Shaunmac68/PAT-ECG/Heart Beat Perception Study 2023 v2.1 Commented/Labels for box.docx

Encoder

Speakers

R-Wave Signal

Vibration Signal
