Shaunmac68/PAT-ECG/Heart Beat Perception Study 2023 v2.1 Commented/PAT Task Script.pptx

## PAT TASK SCRIPT – COMPUTER SCREEN

## Welcome to the task – please read the following instructions carefully

PRESS SPACEBAR TO CONTINUE

## This part of the study will test how well you can match your heartbeat with auditory tones

Once you press the spacebar, you will hear a series of tones, those tones represent your own heartbeats

PRESS SPACEBAR TO CONTINUE

## Slide 4

EXAMPLE HEARTBEAT

EXAMPLE
TONE

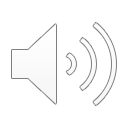
[picture p1: figure]

NOTICE HOW THE TONE IS OUT OF SYNC WITH YOUR HEARBEATS?

PRESS SPACEBAR TO CONTINUE

## Slide 5

It may seem as if there is a delay between the tones you can hear and your own heartbeats you feel

In order to rectify the delay, you will be asked to rotate the dial until the sounds are in sync

PRESS SPACEBAR TO CONTINUE

## Slide 6

TURN LEFT

TURN RIGHT

Turn the dial so that the tone is simultaneous with your perception of the heartbeat

PRESS SPACEBAR TO CONTINUE

## Slide 7

TURN LEFT

Once you are happy with your choice, PRESS SPACEBAR TO CONTINUE

TURN RIGHT

## Slide 8

After each trial you will rate how confident you were about matching your heartbeat to the tone

On a scale of 1 (not confident at all) to 10 (extremely confident) how confident are you that you matched the tone to your heartbeat?
1……………………………………………………………………………………………………………………………………………………….10

Once you are happy with your choice, PRESS SPACEBAR TO CONTINUE

## Slide 9

FOR THE DURATION OF THIS TASK, PLEASE SIT AS STILL AS POSSIBLE AND REFRAIN FROM TENSING YOUR MUSCLES OR ALTERING YOUR BREATHING

PRESS SPACEBAR TO CONTINUE

## Slide 10

REMEMBER
Move the dial so the tone matches your heartbeat to the best of your perception

PRESS SPACEBAR TO CONTINUE

## PHASE ADJUSMENT TASK BEGINS TASK BEGINS
