Shaunmac68/PAT-ECG/CircuitDiagram.jpg

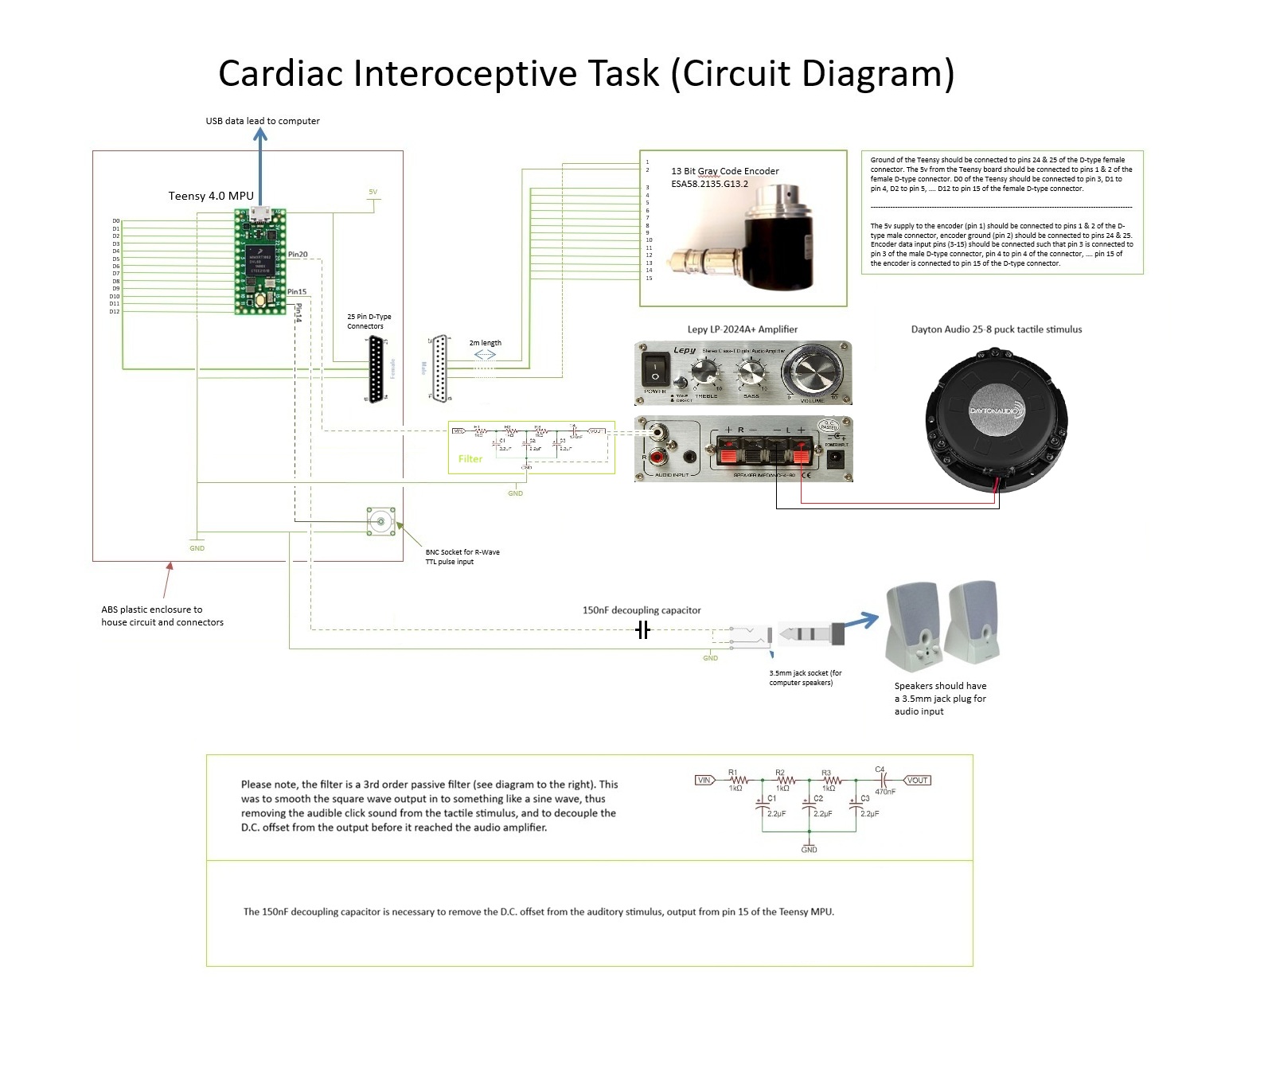
CircuitDiagram.jpg
